caltabid/MidiPedalBoard/Documents/STM32pedalStomps.pdf

### Features - 8 Potentiometers (7 general purpose + Mode)

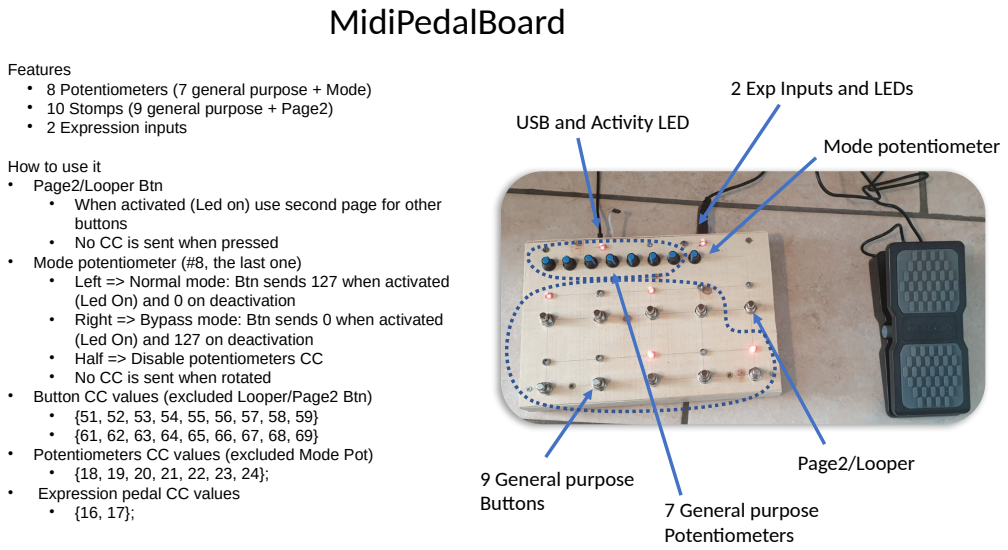
[picture p4: page 1]
MidiPedalBoard; Page2/Looper; Mode potentiometer; 7 General purpose Potentiometers; 9 General purpose Buttons

2 Exp Inputs and LEDs

● 10 Stomps (9 general purpose + Page2)
● 2 Expression inputs

USB and Activity LED

How to use it
• Page2/Looper Btn
• When activated (Led on) use second page for other
buttons
• No CC is sent when pressed
• Mode potentiometer (#8, the last one)
• Left => Normal mode: Btn sends 127 when activated
(Led On) and 0 on deactivation
• Right => Bypass mode: Btn sends 0 when activated
(Led On) and 127 on deactivation
• Half => Disable potentiometers CC
• No CC is sent when rotated
• Button CC values (excluded Looper/Page2 Btn)
• Potentiometers CC values (excluded Mode Pot)
• Expression pedal CC values

STM32pedalStomp | STM32F4DISCOVERY

## Power

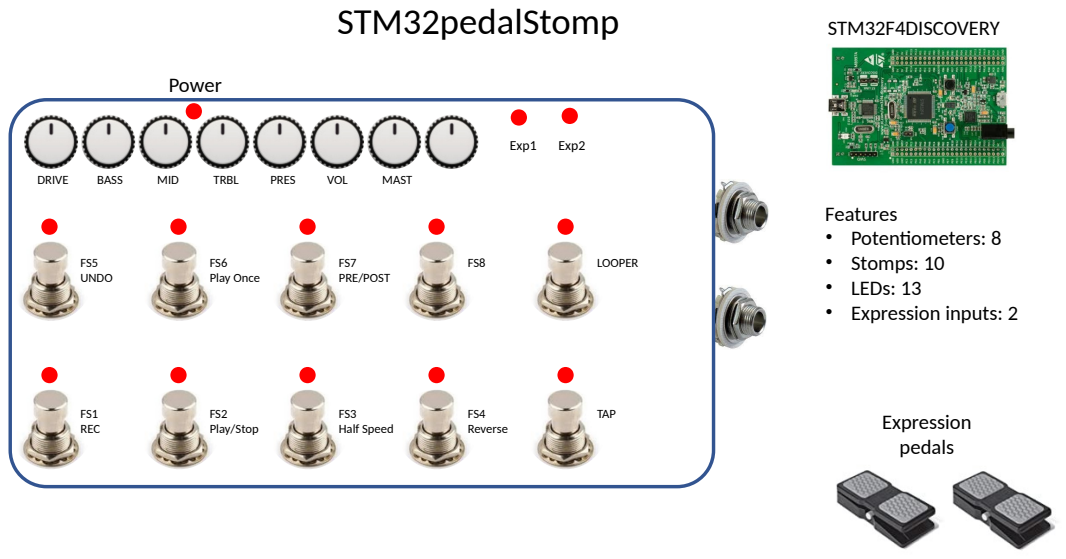
[picture p5: page 2]
Features • Potentiometers: 8 • Stomps: 10 • LEDs: 13 • Expression inputs: 2; Expression pedals; DRIVE; BASS; MID; TRBL; PRES; VOL; MAST; FS1 REC; FS2 Play/Stop; FS3 Half Speed; FS4 Reverse; TAP; FS5 UNDO; FS6 Play Once; FS7 PRE/POST; LOOPER; Exp1; Exp2

# STM32pedalStomp

## Analog example controls

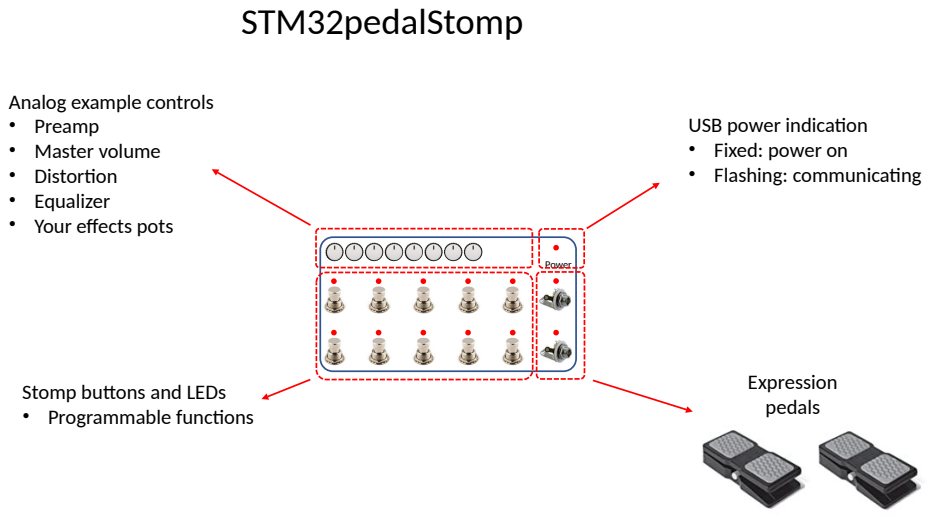
[picture p6: page 3]
Expression pedals; Power

• Preamp
• Master volume
• Distortion
• Equalizer
• Your effects pots

USB power indication
• Fixed: power on
• Flashing: communicating

Stomp buttons and LEDs
• Programmable functions

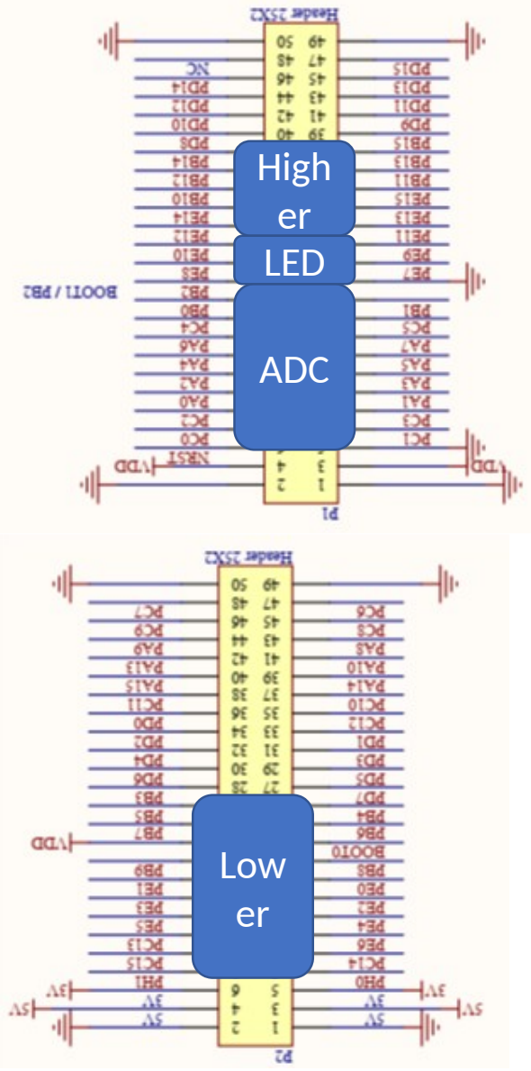
[picture p7: figure]
ADC; High er LED; Low er

# STM32 pin assignments

## - Higher row Stomp 1:5 - Btn: PE11:15 - LED: PB11:15 - LEDs: - LD_PWR: PE9 - LD_Exp1: PE8 - LD_Exp2: PE7 - Lower row Stomp 6:10 - Btn: PE0,2,4,5,6 - LED:PD7,PB4,5,7,8 - Board Btn and LEDs - PA0 (PB blue) - PD13 (LED3) - PD12 (LED4) - PD14 (LED5) - PD15 (LED6)

- HW modifications - Connect PA9 (P2.44) to 5V (P2.4) (USB power supply) - Remove R46 (Enable Exp2) - Potentiometers (8) and expression inputs (2) 1. PA0 ADC1_IN0 (removing SB20) 2. PA1 ADC1_IN1 3. PA2 ADC1_IN2 4. PA3 ADC1_IN3 5. PC1 ADC1_IN11 6. PC2 ADC1_IN12 7. PC4 ADC1_IN14 8. PC5 ADC1_IN15 9. PB0 ADC1_IN8 (Exp1) 10. PB1 ADC1_IN9 (Exp2)

# HW/SW

## STOMP

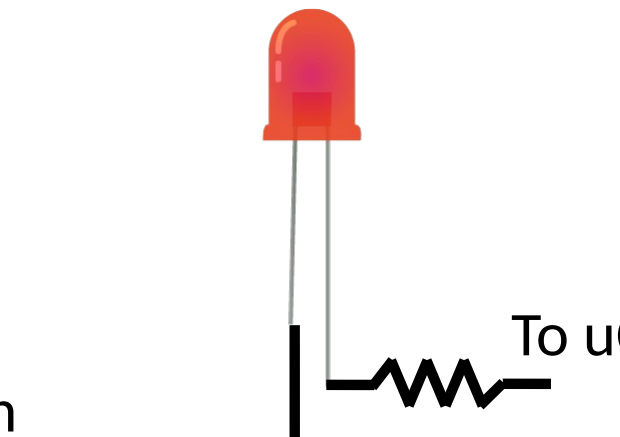
[picture p8: figure]
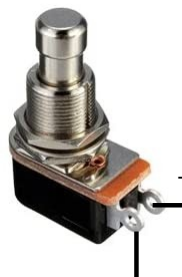
[picture p9: figure]

## To uC pin

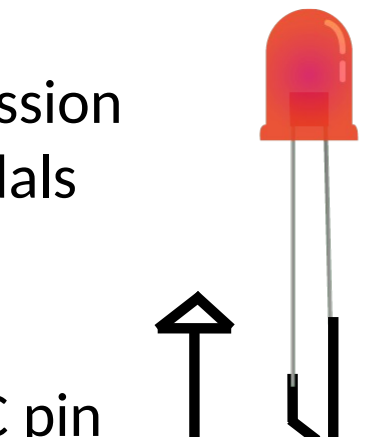
[picture p10: figure]

POT | Expression pedals

## To uC pin

## To uC ADC pin

## To uC LED pin

## LED

## To uC pin

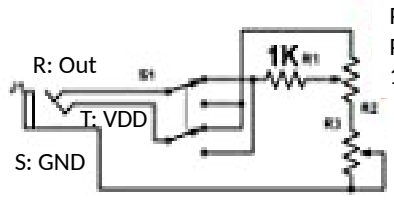
[picture p11: figure]
R: Out; S: GND; T: VDD

Pedal
Pot
11k

Trim Pot
52k

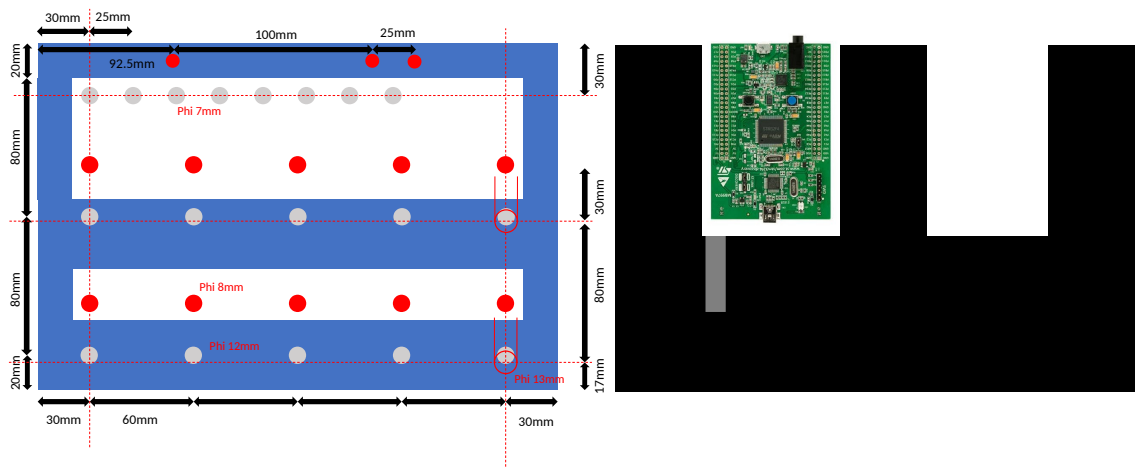
[picture p12: page 6]
Phi 7mm; Phi 12mm

Phi 8mm

Phi 13mm

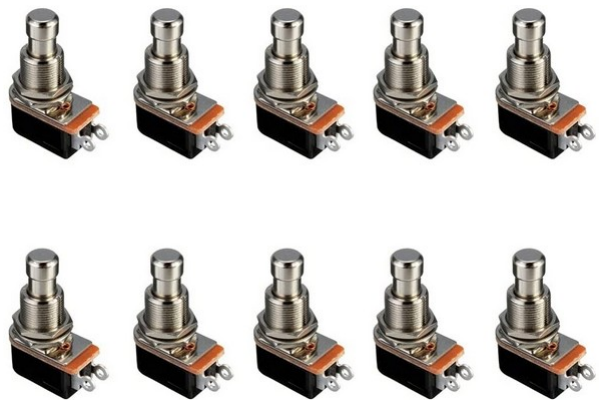
[picture p13: figure]

- STM32F411E-DISCO
- 18 €
- Disc4 https://it.rs-online.com/web/p/strumenti-di-sviluppo-per-microcontrollori/8463503/
- Potentiometers:
- 8€ (price for 10), hole phi 6mm, knob phi 16mm
- https://www.amazon.it/dp/B07ZJL91YP
- Stomps:
- 22€ (price for 10), hole phi 10mm
- https://www.amazon.it/dp/B0734ZR3FY
- LED mount 5mms:
- 8.5€ (price for 20)
- https://www.amazon.it/PORTALED-ACCIAO-CROMATO-pannello-fissaggio/dp/B0162UO9VC
- Jack TRS 6,35 mm (Expression inputs)
- 7€ (price for 2)
- https://www.amazon.it/dp/B07BRQXQVL
- Expression pedals (optional)
- 17€ (each)
- https://www.amazon.it/dp/B000NLRWEI
- Case:

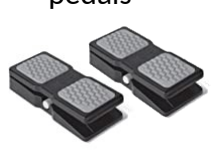
[picture p14: figure]
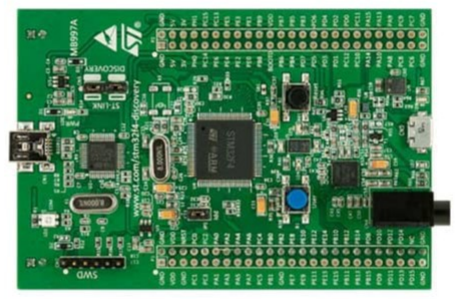
[picture p15: figure]

- 10€ ?
- Others:
- 13 red LEDs
- 13x 1kOhm
- TOT (no expr-pedal and expr inputs): 65€
- TOT (1 expr pedal): 90€

# BOM

## STM32F4Discovery Expression pedals

## Stomp buttons

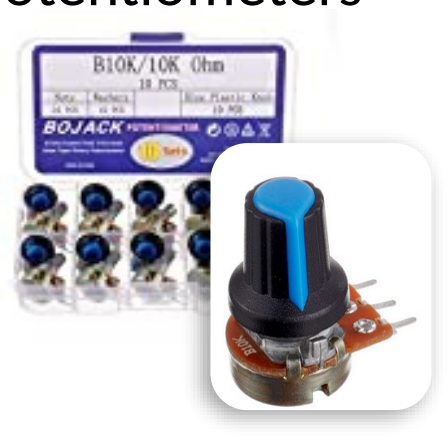
[picture p16: figure]

## Potentiometers

## LED mount

- Phi: 11.5mm
- W: 13 mm
- H: 31mm
- D: 9mm

D

H

W

## Phi

- Phi: 6.5mm
- D: 17mm
- Phi: 8 mm
- Phi: 9mm
- D: 19mm

## Jack TRS

# Other Devices

- MeloAudio USB MIDI
- 10 Stomps
- No potentiometers
- 2 expression pedal inputs
- 130€
- https://www.amazon.it/dp/B07F1GLGCL
- LINE6 FBV Express MKII
- 4 stomps
- 1 expression pedal
- No potentiometer
- Tuner (only if connected to line 6 devices via rj45)
- 86€
- https://www.strumentimusicali.net/product_info.php/products_id/8316/line6-fbv-express-mkii.html

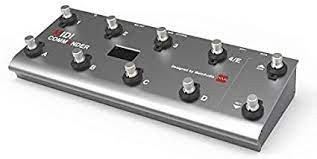
[picture p17: figure]
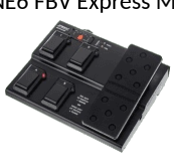
[picture p18: figure]

## LINE6 FBV Express MKII

## MeloAudio USB MIDI

# Other projects and resources

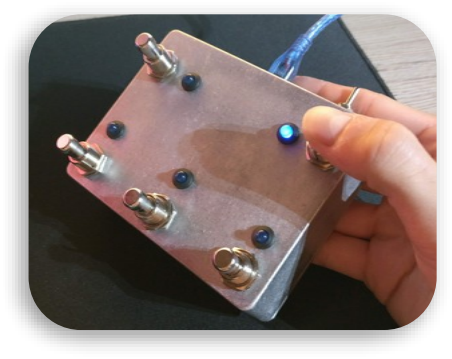
[picture p19: figure]

Arduino MIDI Footswitch
- https://github.com/Hecsall/arduino-midi-footswitch

STM32 projects
- https://github.com/keshikan/CureMIDI8
- https://github.com/ripxorip/stm32_usb_midi
- https://github.com/sebseb7/stm32-midi-demo
- https://github.com/guitarfriiik/stm32_usb_midi

Midi tools
- https://mountainutilities.eu/miditools

MIDI format
- CC table https://www.midi.org/specifications-old/item/table-3-control-change-messages-data-bytes-2
- Tempo (FF 51 03 xx xx xx) https://it.wikipedia.org/wiki/Musical_Instrument_Digital_Interface

## Arduino MIDI Footswitch

# Line6 POD HD 500

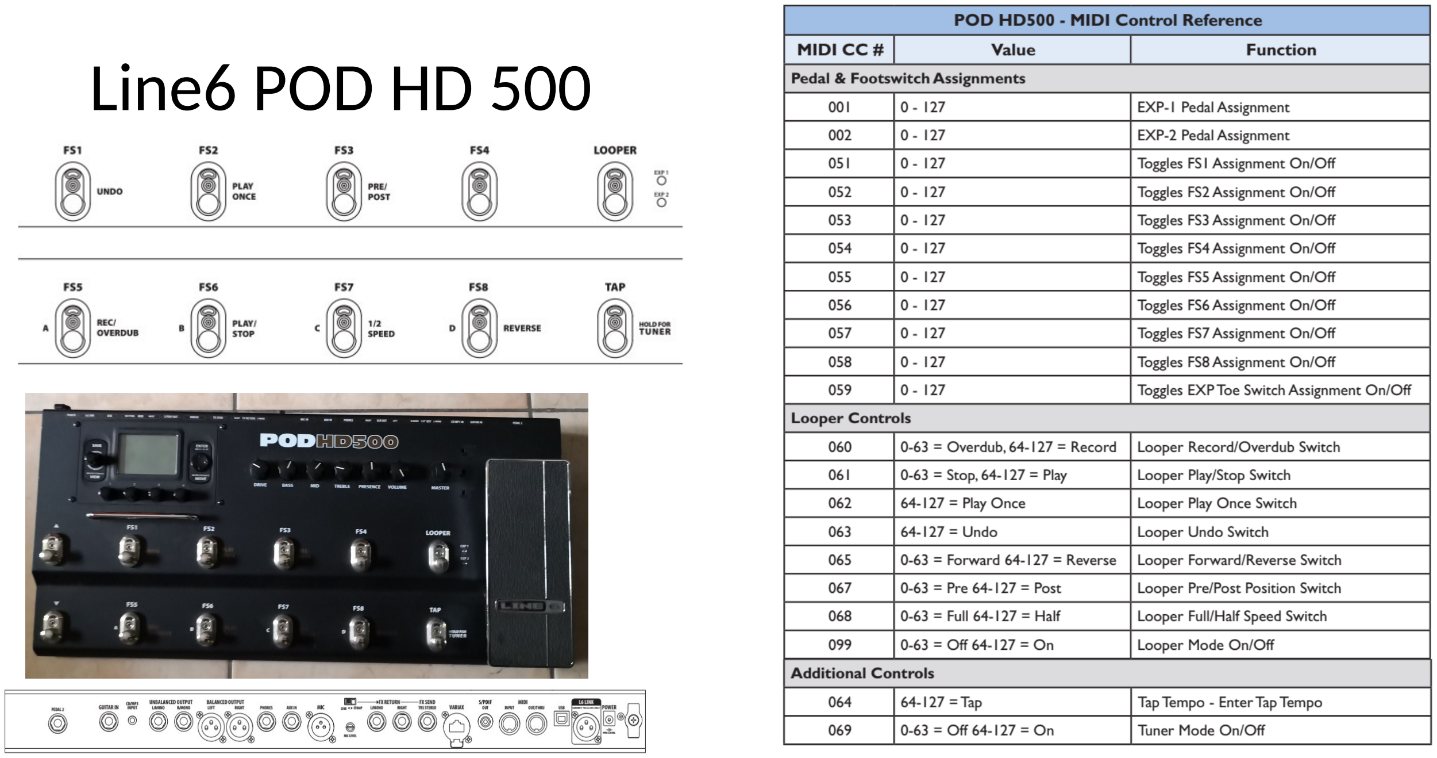
[picture p20: page 10]
