caltabid/MidiPedalBoard/Documents/01_first_proto.jpeg

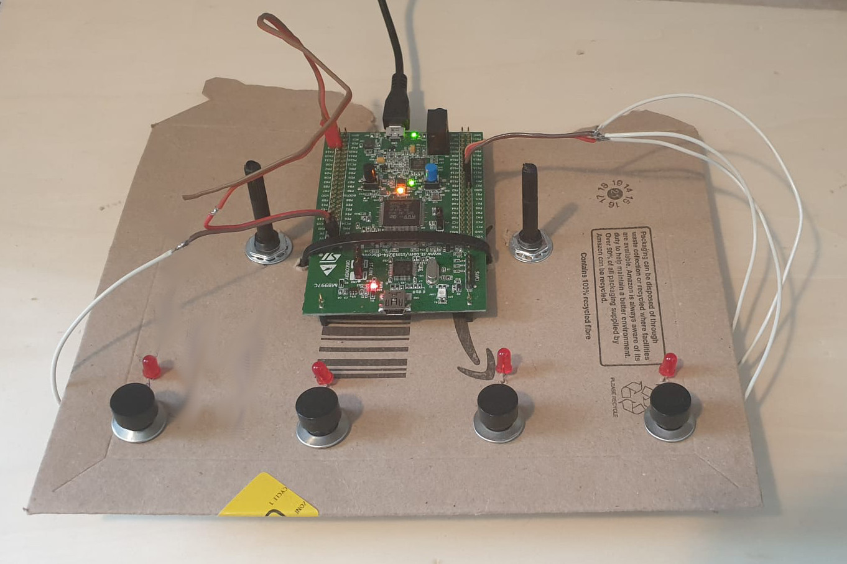
Documents/01_first_proto.jpeg
