caltabid/MidiPedalBoard/stm32/Core/Src/main.c

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
/* Includes ------------------------------------------------------------------*/
#include "main.h"
#include "usb_device.h"

/* USER CODE BEGIN Includes */
#include "usbd_midi_if.h"
#include "Process.h"
/* USER CODE END Includes */

ADC_HandleTypeDef hadc1;
DMA_HandleTypeDef hdma_adc1;

TIM_HandleTypeDef htim7;

/* USER CODE BEGIN PV */
uint8_t uart_rx_dat[MIDI_IN_JACK_NUM];
uint16_t AD_RES[10];

/* USER CODE END PV */

void SystemClock_Config(void);
static void MX_GPIO_Init(void);
static void MX_DMA_Init(void);
static void MX_TIM7_Init(void);
static void MX_ADC1_Init(void);
/* USER CODE BEGIN 0 */
uint16_t *getADCbuffer(void)
{
  return AD_RES;
}
/* USER CODE END 0 */

/**
  * @brief  The application entry point.
  * @retval int
  */
int main(void)
{
  /* MCU Configuration--------------------------------------------------------*/

  /* Reset of all peripherals, Initializes the Flash interface and the Systick. */
  HAL_Init();

  /* USER CODE BEGIN Init */
  ProcessInit();

  /* USER CODE END Init */

  /* Configure the system clock */
  SystemClock_Config();

  /* Initialize all configured peripherals */
  MX_GPIO_Init();
  MX_DMA_Init();
  MX_USB_DEVICE_Init();
  MX_TIM7_Init();
  MX_ADC1_Init();
  /* USER CODE BEGIN 2 */

  HAL_TIM_Base_Start_IT(&htim7);

	//USB-MIDI Driver Init
  MX_USB_MIDI_INIT();
  
  // Calibrate The ADC On Power-Up For Better Accuracy
  //HAL_ADCEx_Calibration_Start(&hadc1);
  // Start ADC Conversion
  HAL_ADC_Start_DMA(&hadc1, (uint32_t*) AD_RES, 10);

  if(FUNC_ERROR == midiInit() ){
	  while(1){
		  HAL_GPIO_WritePin(LD_PWR_GPIO_Port, LD_PWR_Pin, (GPIO_PinState)SET);
		  HAL_Delay(500);
		  HAL_GPIO_WritePin(LD_PWR_GPIO_Port, LD_PWR_Pin, (GPIO_PinState)RESET);
		  HAL_Delay(500);
	  }
  }
  
  /* USER CODE END 2 */

  /* Infinite loop */
  /* USER CODE BEGIN WHILE */
  while (1)
  {
    /* USER CODE END WHILE */

    /* USER CODE BEGIN 3 */
    HAL_Delay(1);
    ProcessExecute();
  }
  /* USER CODE END 3 */
}

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
