caltabid/MidiPedalBoard/(commit log)

2021-05-21 Added STM32pedalStomps.pdf; Improved Readme, now containing also CC values and info on Page2 button and Mode potentiometer; Renamed main to .c and added wrapper for accessing Cpp classes, this is to 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
2021-06-05 Implemented stateless looping buttons (second page, front buttons); Reduced anti-bouncing filter.
